elitetq/JAARK/PCB/JAARK_PCB_MOTOR/JAARK_PCB_MOTOR_BOM.xlsx

Prj: | JAARK_PCB_MOTOR.csv |  |  |  | Board Qty: | 1
Co.: |  |  |  |  | Unit Cost: | $13.34
Prj date: | 2026-02-08 11:43:04 (file) |  |  |  | Total Cost: | $13.34 |  |  |  |  | $13.34 | 19 of 19 parts found
$ date: | 2026-02-08 11:43:17
Global Part Info |  |  |  |  |  |  | Digi-Key
Refs | Value | Footprint | Manf# | Qty | Unit$ | Ext$ | Avail | Purch | Unit$ | MOQ | Ext$ | Cat#
C1,C4,C5 | ??? | ??? | CL21B104KBCNNNC | 3 | $0.080 | $0.24 | 3599108 |  | $0.080 | 1 | $0.24 | 1276-1003-1-ND (https://www.digikey.com/en/products/detail/samsung-electro-mechanics/CL21B104KBCNNNC/3886661)
C2 | ??? | ??? | CL21A106KAYNNNG (https://weblib.samsungsem.com/mlcc/mlcc-ec-data-sheet.do?partNumber=CL05Y105KP6VPN) | 1 | $0.150 | $0.15 | 386143 |  | $0.150 | 1 | $0.15 | 1276-6454-1-ND (https://www.digikey.com/en/products/detail/samsung-electro-mechanics/CL21A106KAYNNNG/3894413)
C3,C13,C15 | ??? | ??? | C0805C104K5RACTU (https://yageogroup.com/content/datasheet/asset/file/KEM_C1002_X7R_SMD) | 3 | $0.080 | $0.24 | 5222574 |  | $0.080 | 1 | $0.24 | 399-C0805C104K5RACTUCT-ND (https://www.digikey.com/en/products/detail/kemet/C0805C104K5RACTU/411169)
C6 | ??? | ??? | CL21C221JBANNNC | 1 | $0.100 | $0.10 | 124315 |  | $0.100 | 1 | $0.10 | 1276-1164-1-ND (https://www.digikey.com/en/products/detail/samsung-electro-mechanics/CL21C221JBANNNC/3886822)
C7 | ??? | ??? | UWT1V101MCL1GS (https://www.nichicon.co.jp/english/series_items/catalog_pdf/e-uwt.pdf) | 1 | $0.410 | $0.41 | 235740 |  | $0.410 | 1 | $0.41 | 493-2203-1-ND (https://www.digikey.com/en/products/detail/nichicon/UWT1V101MCL1GS/589944)
C12,C14 | ??? | ??? | C3216X5R1E336M160AC (https://product.tdk.com/system/files/dam/doc/product/capacitor/ceramic/mlcc/catalog/mlcc_commercial_general_en.pdf) | 2 | $1.130 | $2.26 | 71246 |  | $1.130 | 1 | $2.26 | 445-8046-1-ND (https://www.digikey.com/en/products/detail/tdk-corporation/C3216X5R1E336M160AC/2792259)
D4 | ??? | ??? | SMF12CA (https://www.mccsemi.com/pdf/Products/SMF5.0A_SMF200CA(SOD-123FL).pdf) | 1 |  |  | NonStk |  |  | 2500 |  | 353-SMF12CA-TP-ND (https://www.digikey.com/en/products/detail/mcc-micro-commercial-components/SMF12CA-TP/17949888)
IC1 | ??? | ??? | TPS564242DRLR (https://www.ti.com/lit/ds/symlink/tps564242.pdf) | 1 | $0.560 | $0.56 | 12238 |  | $0.560 | 1 | $0.56 | 296-TPS564242DRLRCT-ND (https://www.digikey.com/en/products/detail/texas-instruments/TPS564242DRLR/16585669)
IC9,IC10 | ??? | ??? | DRV8231DDAR (https://www.ti.com/lit/ds/symlink/drv8231.pdf) | 2 | $1.510 | $3.02 | 3151 |  | $1.510 | 1 | $3.02 | 296-DRV8231DDARCT-ND (https://www.digikey.com/en/products/detail/texas-instruments/DRV8231DDAR/16184249)
J1,J5,J6 | ??? | ??? | 1984617 | 3 | $0.860 | $2.58 | 12408 |  | $0.860 | 1 | $2.58 | 277-1721-ND (https://www.digikey.com/en/products/detail/phoenix-contact/1984617/950849)
L1 | ??? | ??? | 74438356018 (https://www.we-online.com/components/products/datasheet/74438356018.pdf) | 1 | $1.940 | $1.94 | 1841 |  | $1.940 | 1 | $1.94 | 732-8231-1-ND (https://www.digikey.com/en/products/detail/würth-elektronik/74438356018/5725346)
Q1#1 | ??? - p1/2 | ??? | SSM3J334R (https://toshiba.semicon-storage.com/info/docget.jsp?did=5579&prodName=SSM3J334R) | 1 | $0.370 | $0.37 | 47397 |  | $0.370 | 1 | $0.37 | SSM3J334RLFCT-ND (https://www.digikey.com/en/products/detail/toshiba-semiconductor-and-storage/SSM3J334R-LF/3863578)
Q1#2 | ??? - p2/2 | ??? | LF (https://www.te.com/commerce/DocumentDelivery/DDEController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) | 1 |  |  | 12000 |  |  | 6000 |  | A104029TR-ND (https://www.digikey.com/en/products/detail/te-connectivity-amp-connectors/583361-3/294165)
R1 | ??? | ??? | CRG0805F220K (https://www.te.com/commerce/DocumentDelivery/DDEController?Action=srchrtrv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) | 1 | $0.100 | $0.10 | 1227152 |  | $0.100 | 1 | $0.10 | A126350CT-ND (https://www.digikey.com/en/products/detail/te-connectivity-passive-product/CRG0805F220K/2380869)
R2 | ??? | ??? | RC0805FR-0730K1L (https://yageogroup.com/content/datasheet/asset/file/PYU-RC_GROUP_51_ROHS_L) | 1 | $0.100 | $0.10 | 95107 |  | $0.100 | 1 | $0.10 | 311-30.1KCRCT-ND (https://www.digikey.com/en/products/detail/yageo/RC0805FR-0730K1L/727845)
R3,R5 | ??? | ??? | RG2012P-203-B-T5 (https://www.susumu.co.jp/dl/?filename=n_catalog_partition01_en.pdf&type=application/pdf) | 2 | $0.100 | $0.20 | 130853 |  | $0.100 | 1 | $0.20 | RG20P20.0KBCT-ND (https://www.digikey.com/en/products/detail/susumu/RG2012P-203-B-T5/1240704)
R4 | ??? | ??? | RC0805FR-0740K2L (https://yageogroup.com/content/datasheet/asset/file/PYU-RC_GROUP_51_ROHS_L) | 1 | $0.100 | $0.10 | 201092 |  | $0.100 | 1 | $0.10 | 311-40.2KCRCT-ND (https://www.digikey.com/en/products/detail/yageo/RC0805FR-0740K2L/727941)
R10,R11 | ??? | ??? | RL1220S-R20-F (https://www.susumu.co.jp/common/pdf/n_catalog_partition08_en.pdf) | 2 | $0.170 | $0.34 | 243936 |  | $0.170 | 1 | $0.34 | RL12S.20FCT-ND (https://www.digikey.com/en/products/detail/susumu/RL1220S-R20-F/432484)
U1 | ??? | ??? | 3586TR (https://www.keyelco.com/product-pdf.cfm?p=1380) | 1 | $0.630 | $0.63 | 54578 |  | $0.630 | 1 | $0.63 | 36-3586TRCT-ND (https://www.digikey.com/en/products/detail/keystone-electronics/3586TR/2746528)
 |  |  |  |  | Total Purchase: | $0.00 | Buy here (https://www.digikey.com/ordering/shoppingcart) |  |  |  | $0.00
KiCost® v1.1.20 |  |  |  |  | Purchase description:
