elitetq/JAARK/PCB/JAARK_PCB_MOTOR/JAARK_PCB_MOTOR.xlsx

Prj: | JAARK_PCB_MOTOR.csv |  |  |  | Board Qty: | 1
Co.: |  |  |  |  | Unit Cost: | $19.26
Prj date: | 2026-02-15 16:47:53 (file) |  |  |  | Total Cost: | $19.26 |  |  |  |  | $19.26 | 21 of 21 parts found
$ date: | 2026-02-15 16:48:51
Global Part Info |  |  |  |  |  |  | Digi-Key
Refs | Value | Footprint | Manf# | Qty | Unit$ | Ext$ | Avail | Purch | Unit$ | MOQ | Ext$ | Cat#
C1,C4,C5 | ??? | ??? | CL21B104KBCNNNC | 3 | $0.080 | $0.24 | 3599108 |  | $0.080 | 1 | $0.24 | 1276-1003-1-ND (https://www.digikey.com/en/products/detail/samsung-electro-mechanics/CL21B104KBCNNNC/3886661)
C2 | ??? | ??? | CL21A106KAYNNNG (https://weblib.samsungsem.com/mlcc/mlcc-ec-data-sheet.do?partNumber=CL05Y105KP6VPN) | 1 | $0.150 | $0.15 | 386143 |  | $0.150 | 1 | $0.15 | 1276-6454-1-ND (https://www.digikey.com/en/products/detail/samsung-electro-mechanics/CL21A106KAYNNNG/3894413)
C3,C8,C9,C13,C15 | ??? | ??? | C0805C104K5RACTU (https://yageogroup.com/content/datasheet/asset/file/KEM_C1002_X7R_SMD) | 5 | $0.080 | $0.40 | 5222574 |  | $0.080 | 1 | $0.40 | 399-C0805C104K5RACTUCT-ND (https://www.digikey.com/en/products/detail/kemet/C0805C104K5RACTU/411169)
C6 | ??? | ??? | CL21C221JBANNNC | 1 | $0.100 | $0.10 | 124315 |  | $0.100 | 1 | $0.10 | 1276-1164-1-ND (https://www.digikey.com/en/products/detail/samsung-electro-mechanics/CL21C221JBANNNC/3886822)
C7 | ??? | ??? | UWT1V101MCL1GS (https://www.nichicon.co.jp/english/series_items/catalog_pdf/e-uwt.pdf) | 1 | $0.410 | $0.41 | 235740 |  | $0.410 | 1 | $0.41 | 493-2203-1-ND (https://www.digikey.com/en/products/detail/nichicon/UWT1V101MCL1GS/589944)
C12,C14 | ??? | ??? | C3216X5R1E336M160AC (https://product.tdk.com/system/files/dam/doc/product/capacitor/ceramic/mlcc/catalog/mlcc_commercial_general_en.pdf) | 2 | $1.130 | $2.26 | 71246 |  | $1.130 | 1 | $2.26 | 445-8046-1-ND (https://www.digikey.com/en/products/detail/tdk-corporation/C3216X5R1E336M160AC/2792259)
D4 | ??? | ??? | SMF12CA (https://www.mccsemi.com/pdf/Products/SMF5.0A_SMF200CA(SOD-123FL).pdf) | 1 |  |  | NonStk |  | MOQ=2500 | 2500 |  | 353-SMF12CA-TP-ND (https://www.digikey.com/en/products/detail/mcc-micro-commercial-components/SMF12CA-TP/17949888)
IC1 | ??? | ??? | TPS564242DRLR (https://www.ti.com/lit/ds/symlink/tps564242.pdf) | 1 | $0.560 | $0.56 | 12238 |  | $0.560 | 1 | $0.56 | 296-TPS564242DRLRCT-ND (https://www.digikey.com/en/products/detail/texas-instruments/TPS564242DRLR/16585669)
IC9,IC10 | ??? | ??? | DRV8231DDAR (https://www.ti.com/lit/ds/symlink/drv8231.pdf) | 2 | $1.510 | $3.02 | 3151 |  | $1.510 | 1 | $3.02 | 296-DRV8231DDARCT-ND (https://www.digikey.com/en/products/detail/texas-instruments/DRV8231DDAR/16184249)
J1,J4-J7 | ??? | ??? | 1984617 | 5 | $0.860 | $4.30 | 12408 |  | $0.860 | 1 | $4.30 | 277-1721-ND (https://www.digikey.com/en/products/detail/phoenix-contact/1984617/950849)
J2 | ??? | ??? | SSW-119-01-T-D | 1 | $3.570 | $3.57 | NonStk |  | $3.570 | 1 | $3.57 | SAM1212-19-ND (https://www.digikey.com/en/products/detail/samtec-inc/SSW-119-01-T-D/1112237)
J3 | ??? | ??? | PPPC061LGBN-RC | 1 | $0.570 | $0.57 | 11923 |  | $0.570 | 1 | $0.57 | S5481-ND (https://www.digikey.com/en/products/detail/sullins-connector-solutions/PPPC061LGBN-RC/775939)
L1 | ??? | ??? | 74438356018 (https://www.we-online.com/components/products/datasheet/74438356018.pdf) | 1 | $1.940 | $1.94 | 1841 |  | $1.940 | 1 | $1.94 | 732-8231-1-ND (https://www.digikey.com/en/products/detail/würth-elektronik/74438356018/5725346)
Q1 | ??? | ??? | SSM3J334R (https://toshiba.semicon-storage.com/info/docget.jsp?did=5579&prodName=SSM3J334R) | 1 | $0.370 | $0.37 | 47397 |  | $0.370 | 1 | $0.37 | SSM3J334RLFCT-ND (https://www.digikey.com/en/products/detail/toshiba-semiconductor-and-storage/SSM3J334R-LF/3863578)
Q2 | ??? | ??? | 2N4403TFR (https://www.onsemi.com/pub/Collateral/2N4403T.PDF) | 1 | $0.190 | $0.19 | 18574 |  | $0.190 | 1 | $0.19 | 2N4403D26ZCT-ND (https://www.digikey.com/en/products/detail/onsemi/2N4403TFR/458822)
R1 | ??? | ??? | CRG0805F220K (https://www.te.com/commerce/DocumentDelivery/DDEController?Action=srchrtrv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) | 1 | $0.100 | $0.10 | 1227152 |  | $0.100 | 1 | $0.10 | A126350CT-ND (https://www.digikey.com/en/products/detail/te-connectivity-passive-product/CRG0805F220K/2380869)
R2 | ??? | ??? | CRG0805F30K (https://www.te.com/commerce/DocumentDelivery/DDEController?Action=srchrtrv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) | 1 | $0.100 | $0.10 | 58878 |  | $0.100 | 1 | $0.10 | A126360CT-ND (https://www.digikey.com/en/products/detail/te-connectivity-passive-product/CRG0805F30K/2380886)
R3 | ??? | ??? | RG2012P-203-B-T5 (https://www.susumu.co.jp/dl/?filename=n_catalog_partition01_en.pdf&type=application/pdf) | 1 | $0.100 | $0.10 | 130853 |  | $0.100 | 1 | $0.10 | RG20P20.0KBCT-ND (https://www.digikey.com/en/products/detail/susumu/RG2012P-203-B-T5/1240704)
R4 | ??? | ??? | RC0805FR-0740K2L (https://yageogroup.com/content/datasheet/asset/file/PYU-RC_GROUP_51_ROHS_L) | 1 | $0.100 | $0.10 | 201092 |  | $0.100 | 1 | $0.10 | 311-40.2KCRCT-ND (https://www.digikey.com/en/products/detail/yageo/RC0805FR-0740K2L/727941)
R10,R11 | ??? | ??? | RL1220S-R20-F (https://www.susumu.co.jp/common/pdf/n_catalog_partition08_en.pdf) | 2 | $0.170 | $0.34 | 243936 |  | $0.170 | 1 | $0.34 | RL12S.20FCT-ND (https://www.digikey.com/en/products/detail/susumu/RL1220S-R20-F/432484)
U1 | ??? | ??? | 3568 (https://www.te.com/usa-en/product-35684.datasheet.pdf) | 1 | $0.440 | $0.44 | 63044 |  | $0.440 | 1 | $0.44 | 35684-ND (https://www.digikey.com/en/products/detail/te-connectivity-amp-connectors/35684/293074)
 |  |  |  |  | Total Purchase: | $0.00 | Buy here (https://www.digikey.com/ordering/shoppingcart) |  |  |  | $0.00
KiCost® v1.1.20 |  |  |  |  | Purchase description: |  |  | #N/A
