elitetq/JAARK/PCB/JAARK_PCB_MOTOR/JAARK_PCB_MOTOR.kicad_pcb

## KiCad design PCB/JAARK_PCB_MOTOR/JAARK_PCB_MOTOR.kicad_pcb (2026-03-23)

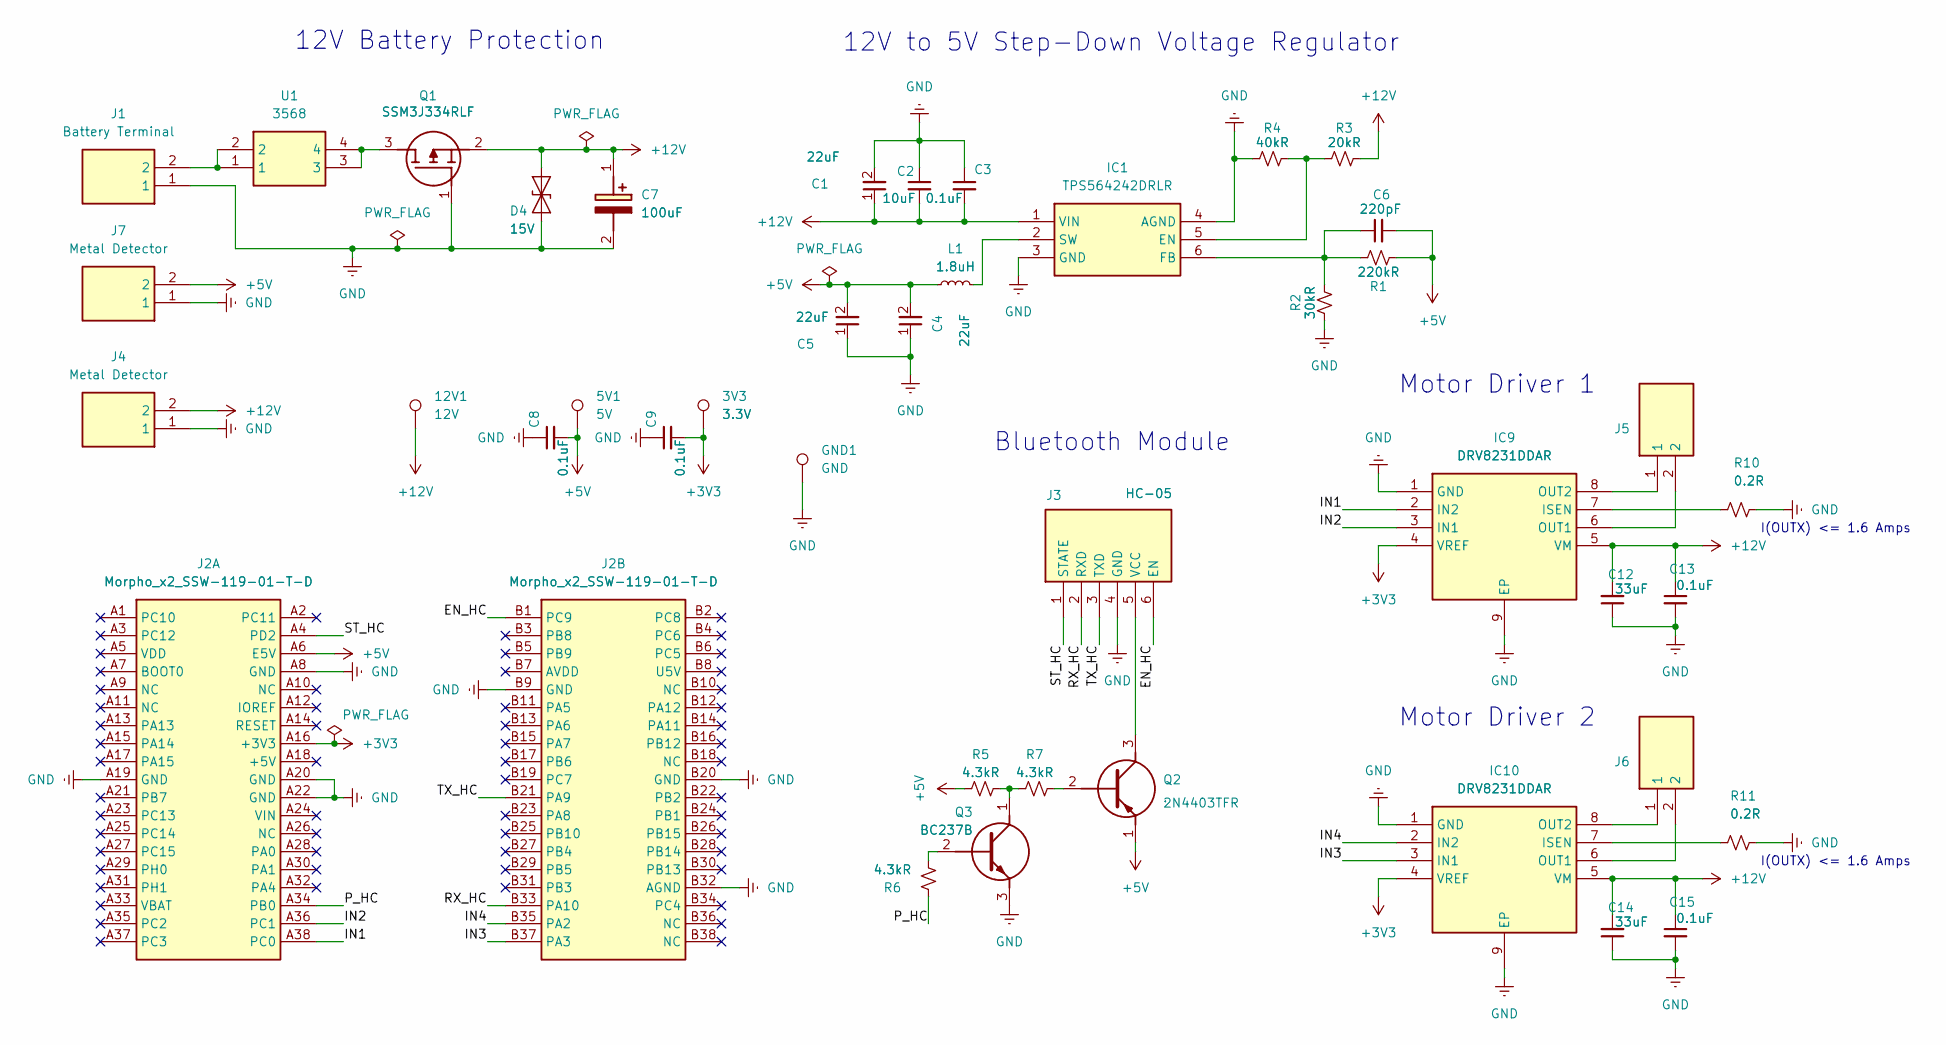
[picture p14: schematic JAARK_PCB_MOTOR.kicad_sch]

Parts:
3V3: 3.3V; TestPoint_Pad_1.5x1.5mm
5V1: 5V; TestPoint_Pad_1.5x1.5mm
12V1: 12V; TestPoint_Pad_1.5x1.5mm
C1: 22uF; CAPC2012X95N; MPN CL21A226MAYNNNE; Mouser Part Number 187-CL21B104KBCNNNC
C2: 10uF; CAPC2012X145N; Manufacturer_Part_Number CL21A106KAYNNNG; Mouser Part Number 187-CL21A106KAYNNNG
C3, C8, C9, C13, C15: 0.1uF; C0805; Manufacturer_Part_Number C0805C104K5RACTU; Mouser Part Number 80-C0805C104K5R
C4, C5: 22uF; CAPC2012X95N; Manufacturer_Part_Number CL21B104KBCNNNC; Mouser Part Number 187-CL21B104KBCNNNC
C6: 220pF; CAPC2012X75N; Manufacturer_Part_Number CL21C221JBANNNC; Mouser Part Number 187-CL21C221JBANNNC
C7: 100uF; CAPAE660X800N; Manufacturer_Part_Number UWT1V101MCL1GS; Mouser Part Number 647-UWT1V101MCL1S
C12, C14: 33uF; CAPC3216X180N; Manufacturer_Part_Number C3216X5R1E336M160AC; Mouser Part Number 810-C3216X5R1E336M
D4: 15V; SODFL3616X135N; Manufacturer_Part_Number SMF12CA
GND1: GND; TestPoint_Pad_1.5x1.5mm
IC1: TPS564242DRLR; SOTFL50P160X60-6N; Manufacturer_Part_Number TPS564242DRLR; Mouser Part Number 595-TPS564242DRLR
IC9, IC10: DRV8231DDAR; SOIC127P600X170-9N; Manufacturer_Part_Number DRV8231DDAR; Mouser Part Number 595-DRV8231DDAR
J1: Battery Terminal; 1984617; Manufacturer_Part_Number 1984617; Mouser Part Number 651-1984617
J2: Morpho_x2_SSW-119-01-T-D; STM_Nucleo_Morpho_x2_Footprint; Manufacturer_Part_Number SSW-119-01-T-D; Mouser Part Number 200-SSW11901TD
J3: HC-05; PPPC061LGBNRC; Manufacturer_Part_Number PPPC061LGBN-RC
J4, J7: Metal Detector; 1984617; Manufacturer_Part_Number 1984617; Mouser Part Number 651-1984617
J5, J6: 1984617; Manufacturer_Part_Number 1984617; Mouser Part Number 651-1984617
L1: 1.8uH; INDPM4141X200N; Manufacturer_Part_Number 74438356018; Mouser Part Number 710-74438356018
Q1: SSM3J334RLF; 2SC2712GRLF; Manufacturer_Part_Number SSM3J334R,LF
Q2: 2N4403TFR; BC33740TA; Manufacturer_Part_Number 2N4403TFR; Mouser Part Number 512-2N4403TFR
Q3: BC237B; TO-92__TO-226_; Manufacturer_Part_Number BC237B; Mouser Part Number 512-BC237B
R1: 220kR; RESC2012X65N; Manufacturer_Part_Number CRG0805F220K; Mouser Part Number 279-CRG0805F220K
R2: 30kR; RESC2012X65N; Manufacturer_Part_Number CRG0805F30K; Mouser Part Number 279-CRG0805F30K
R3: 20kR; RESC2012X50N; Manufacturer_Part_Number RG2012P-203-B-T5; Mouser Part Number 754-RG2012P-203-B-T5
R4: 40kR; RESC2012X60N; Manufacturer_Part_Number RC0805FR-0740K2L; Mouser Part Number 603-RC0805FR-0740K2L
R5, R6, R7: 4.3kR; R_Axial_DIN0207_L6.3mm_D2.5mm_P10.16mm_Horizontal
R10, R11: 0.2R; RESC2013X65N; Manufacturer_Part_Number RL1220S-R20-F; Mouser Part Number 754-RL1220S-R20-F
U1: 3568; Manufacturer_Part_Number 3568; Mouser Part Number 534-3568

Connections:
+3V3: 3V3.1, C9.2, IC9.4 (VREF), IC10.4 (VREF), J2.A16 (+3V3)
+5V: 5V1.1, C4.2, C5.2, C6.2, C8.2, J2.A6 (E5V), J7.2, L1.1, Q2.1 (E), R1.1, R5.1
+12V: 12V1.1, C1.1, C2.2, C3.2, C7.1 (+), C12.2, C13.1, C14.2, C15.1, D4.2 (A2), IC1.1 (VIN), IC9.5 (VM), IC10.5 (VM), J4.2, Q1.2 (S), R3.1
/EN_HC: J2.B1 (PC9), J3.6 (EN)
/IN1: IC9.2 (IN2), J2.A38 (PC0)
/IN2: IC9.3 (IN1), J2.A36 (PC1)
/IN3: IC10.3 (IN1), J2.B37 (PA3)
/IN4: IC10.2 (IN2), J2.B35 (PA2)
/P_HC: J2.A34 (PB0), R6.1
/RX_HC: J2.B33 (PA10), J3.2 (RXD)
/ST_HC: J2.A4 (PD2), J3.1 (STATE)
/TX_HC: J2.B21 (PA9), J3.3 (TXD)
GND: C1.2, C2.1, C3.1, C4.1, C5.1, C7.2 (-), C8.1, C9.1, C12.1, C13.2, C14.1, C15.2, D4.1 (A1), GND1.1, IC1.3 (GND), IC1.4 (AGND), IC9.1 (GND), IC9.9 (EP), IC10.1 (GND), IC10.9 (EP), J1.1, J2.A8 (GND), J2.A19 (GND), J2.A20 (GND), J2.A22 (GND), J2.B9 (GND), J2.B20 (GND), J2.B32 (AGND), J3.4 (GND), J4.1, J7.1, Q1.1 (G), Q3.3 (E), R2.1, R4.2, R10.2, R11.2
unnamed: IC1.5 (EN), R3.2, R4.1
unnamed: C6.1, IC1.6 (FB), R1.2, R2.2
unnamed: IC1.2 (SW), L1.2
unnamed: IC9.7 (ISEN), R10.1
unnamed: IC9.6 (OUT1), J5.2
unnamed: IC9.8 (OUT2), J5.1
unnamed: IC10.7 (ISEN), R11.1
unnamed: IC10.6 (OUT1), J6.2
unnamed: IC10.8 (OUT2), J6.1
unnamed: J1.2, U1.1, U1.2
unnamed: J3.5 (VCC), Q2.3 (C)
unnamed: Q1.3 (D), U1.3, U1.4
unnamed: Q2.2 (B), R7.2
unnamed: Q3.2 (B), R6.2
unnamed: Q3.1 (C), R5.2, R7.1

Notes on the sheet:
I(OUTX) <= 1.6 Amps
Bluetooth Module
Motor Driver 2
12V to 5V Step-Down Voltage Regulator
Motor Driver 1
12V Battery Protection

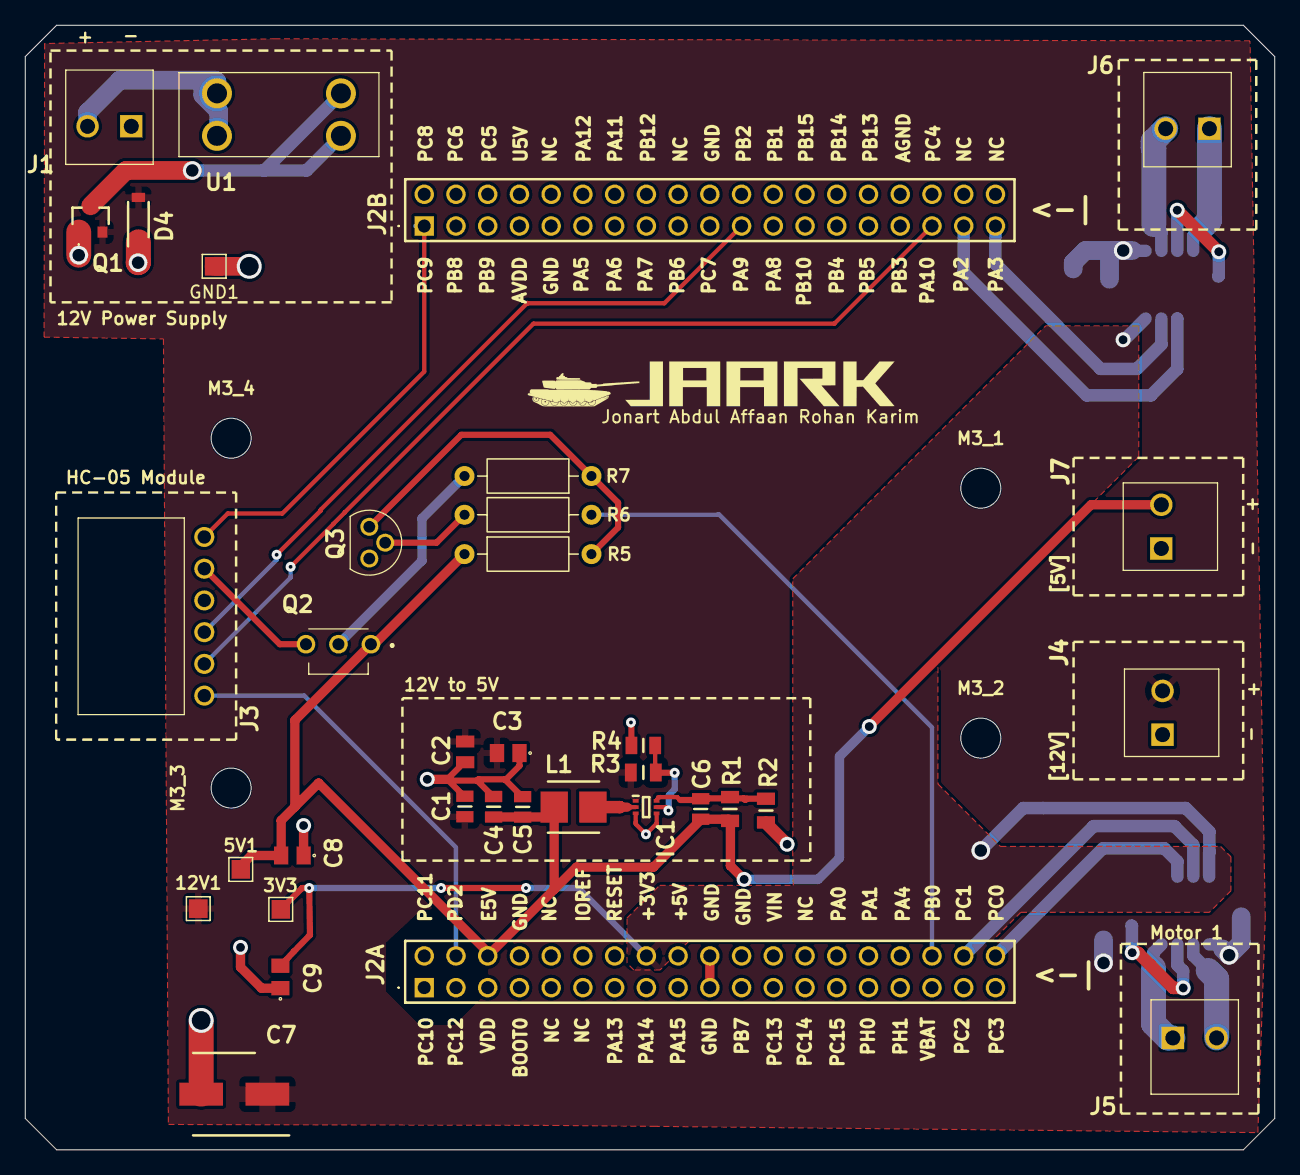
[picture p15: board JAARK_PCB_MOTOR.kicad_pcb from above]

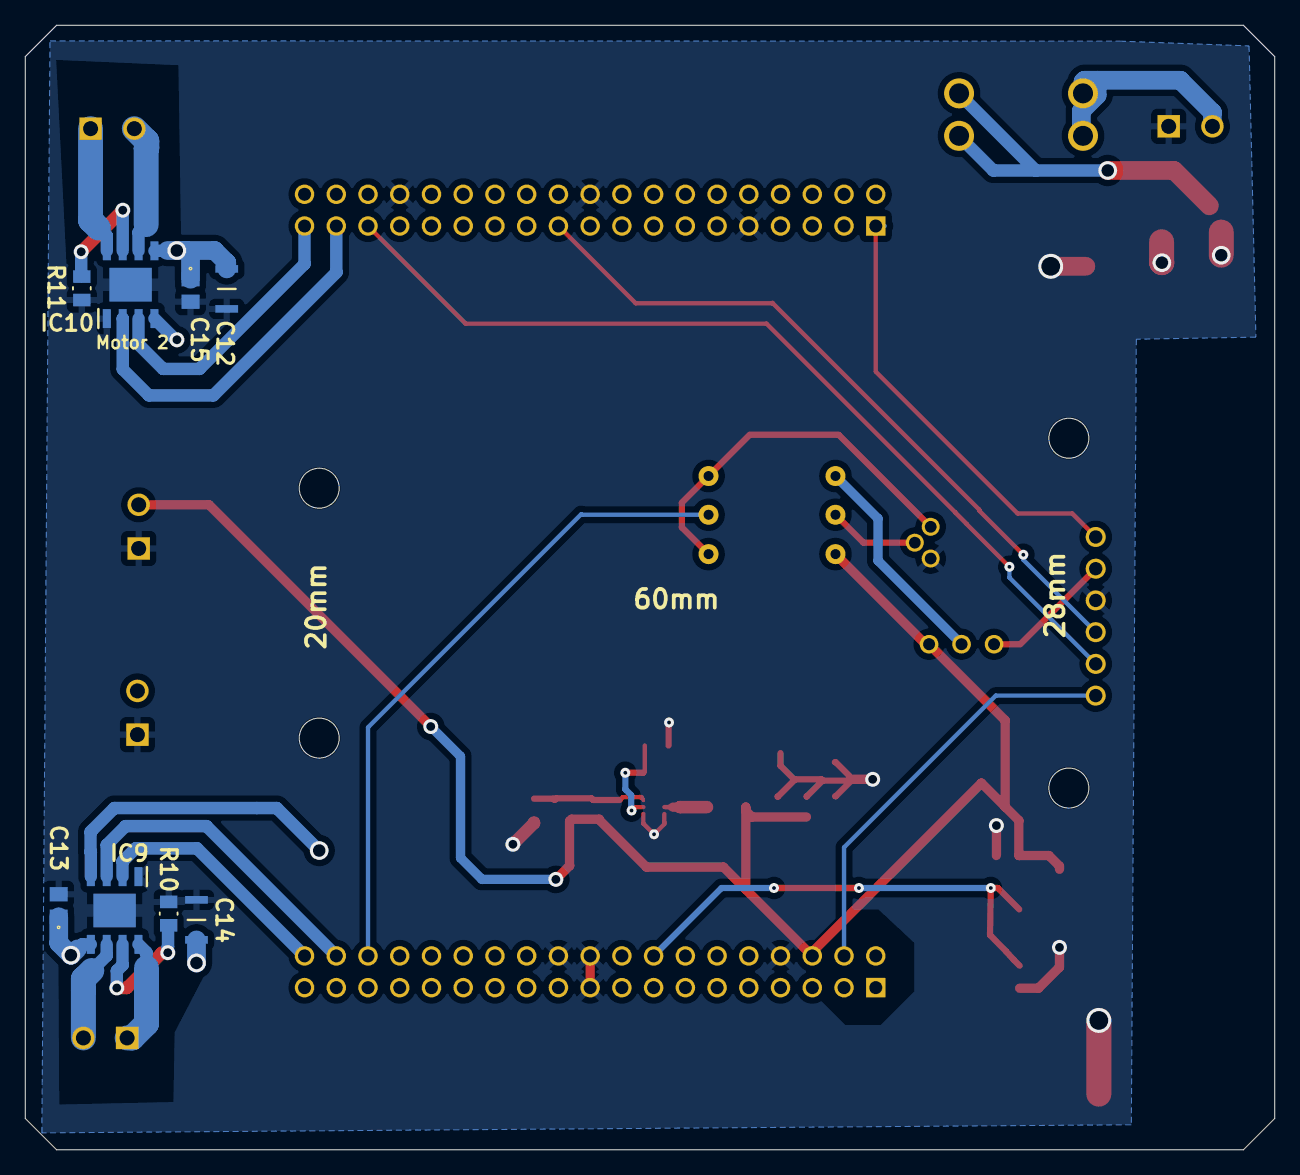
[picture p16: board JAARK_PCB_MOTOR.kicad_pcb from below]

Board: 2 copper layers, 100.0 x 90.0 mm, 46 parts (8 on the bottom side), 28 nets.

Other parts of the board:
M3_1: M3_1; MountingHole_3.2mm_M3
M3_2: M3_2; MountingHole_3.2mm_M3
M3_3: M3_3; MountingHole_3.2mm_M3
M3_4: M3_4; MountingHole_3.2mm_M3
