elitetq/JAARK/STM32/PCB_MOTOR_STM/PCB_MOTOR_STM.ioc

Mcu.UserName=STM32F446RETx
PA0-WKUP.Signal=S_TIM5_CH1
PA1.Signal=GPIO_Output
PA10.Signal=USART1_RX
PA13.GPIO_Label=TMS
PA13.Signal=SYS_JTMS-SWDIO
PA14.GPIO_Label=TCK
PA14.Signal=SYS_JTCK-SWCLK
PA15.Signal=S_TIM2_CH1_ETR
PA2.Signal=USART2_TX
PA3.Signal=USART2_RX
PA4.Signal=ADCx_IN4
PA5.GPIO_Label=LD2 [Green Led]
PA5.Signal=GPIO_Output
PA9.Signal=USART1_TX
PB0.Signal=GPIO_Output
PB10.Signal=GPXTI10
PB14.Signal=S_TIM12_CH1
PB3.GPIO_Label=SWO
PB3.Signal=SYS_JTDO-SWO
PB4.Signal=GPIO_Output
PB7.Signal=GPIO_Output
PB8.Signal=S_TIM10_CH1
PB9.Signal=S_TIM11_CH1
PC0.Signal=GPIO_Input
PC1.Signal=GPIO_Input
PC10.Signal=SPI3_SCK
PC12.Signal=SPI3_MOSI
PC13.GPIO_Label=B1 [Blue PushButton]
PC13.Signal=GPXTI13
PC14-OSC32_IN.Signal=RCC_OSC32_IN
PC15-OSC32_OUT.Signal=RCC_OSC32_OUT
PC2.Signal=GPIO_Input
PC3.Signal=GPIO_Input
PC4.Signal=GPIO_Output
PC6.Signal=S_TIM8_CH1
PC8.Signal=S_TIM8_CH3
PC9.Signal=S_TIM8_CH4
PH0-OSC_IN.Signal=RCC_OSC_IN
PH1-OSC_OUT.Signal=RCC_OSC_OUT
