elitetq/JAARK/STM32/STM32_CONTROLLER/Core/Src/main.c

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
/* Includes ------------------------------------------------------------------*/
#include "main.h"
#include "adc.h"
#include "dma.h"
#include "spi.h"
#include "tim.h"
#include "usart.h"
#include "gpio.h"
#include "string.h"

/* USER CODE BEGIN Includes */
#include "j_st7789.h"

/* USER CODE END Includes */

/* USER CODE BEGIN PM */
// Slave address 2025:08:004B82

/* USER CODE END PM */


/* USER CODE BEGIN PV */
// uint8_t rx_buf[1]; // Data we receive
// uint8_t tx_buf[1]; // Data to transmit
uint8_t pc_rx_buf[1];
uint8_t hc_rx_buf[1];

volatile union { 
  float fnum;
  uint8_t bytes[7];
} FloatPacket; // Float bytes for distance
volatile float fnum_stored = 0;
volatile float sensor_val_stored = 10;
#define SENSOR_DAMP 0.4
#define EXP_SMOOTH(prev_val,new_val,damping_factor) (prev_val * (1-damping_factor) + new_val * (damping_factor));

volatile char metal_detect_flag = 0;
volatile char headlight_flag = 0;

volatile char bt_dat_avail = 0;
volatile char bt_timeout = 0;
volatile uint32_t hal_adc_val = 0; // X
volatile uint32_t hal_adc_val2 = 0; // Y

volatile uint32_t hal1_write_up_prev = 0;
volatile uint32_t hal2_write_up_prev = 0;
volatile uint32_t hal1_write_down_prev = 0;
volatile uint32_t hal2_write_down_prev = 0;
volatile uint8_t hal_combined[4] = {0,0,0,0}; // index 1 {Joystick Data} : index 2 {Headlight Data}
const uint8_t checksum_index = 2;

volatile char headlight_update_debounce = 0;

#define BT_BUF_SIZE 30
#define BG_COL J_BLACK
#define WATCHDOG_BG_COL J_RED

/* USER CODE END PV */

void SystemClock_Config(void);
/* USER CODE BEGIN PFP */

void Reset_DMA_Channel(UART_HandleTypeDef *huart, uint8_t *pData, uint8_t size) {
}


/**
 * @brief generate a checksum for the array given at the checksum index
 * 
 * @param arr Array to be sifted through
 * @param chksum_ind index of checksum (must allow for 2 bytes of storage on an array), if less than 0, will not store any value on the array
 * 
 */
uint16_t Checksum_Generate(uint8_t* arr, int chksum_ind) {
  // Using fletcher 16 algorithm
  uint8_t s1 = 0;
  uint8_t s2 = 0;
  char do_arr_replacement = 1;
  if(chksum_ind < 0) {
    chksum_ind = chksum_ind * -1;
    do_arr_replacement = 0;
  }
  for(int i = 0; i < chksum_ind; i++) {
    s1 += arr[i];
    s2 += s1;
  }
  if(do_arr_replacement) {
    arr[chksum_ind] = s2;
    arr[chksum_ind+1] = s1;
  }
  return ((uint16_t)s2 << 8) + (uint16_t)s1;
}

void Setup_Main_Screen() {
  set_bounds(0,239,0,239);
  set_bg_col(BG_COL);
  fill_area(get_bg_col());

  fill_text(120,90,"Distance (cm)",13,J_11X18_FONT,J_WHITE,J_CENTER);
}

void BT_Watchdog() {
  if(bt_timeout) {
    bt_dat_avail = 0;
    set_bounds(0,239,0,239);
    set_bg_col(WATCHDOG_BG_COL);
    fill_area(get_bg_col());

    fill_text(120,75,"WATCHDOG",-1,J_16X26_FONT,J_WHITE,J_CENTER);
    fill_text(120,102,"No Bluetooth Signal",-1,J_11X18_FONT,J_WHITE,J_CENTER);
    fill_text(120,125,"Attempting Reconnect...",-1,J_7X10_FONT,J_WHITE,J_CENTER);

    HAL_Delay(15);

    uint8_t rec_index1, rec_index2, rec_flag1, rec_flag2, x_pos, y_pos, width;
    rec_index2 = 0;
    rec_index1 = 1;
    rec_flag1 = 0;
    rec_flag2 = 0;
    x_pos = 100;
    y_pos = 165;
    width = 20;

    // 1. Completely abort the UART reception and reset its state machine to READY
    HAL_UART_AbortReceive(&huart1);

    // 2. Clear any lingering hardware errors caused by the disconnect/static
    __HAL_UART_CLEAR_OREFLAG(&huart1);
    __HAL_UART_CLEAR_FEFLAG(&huart1);
    __HAL_UART_CLEAR_NEFLAG(&huart1);

    HAL_UARTEx_ReceiveToIdle_DMA(&huart1, FloatPacket.bytes, sizeof(FloatPacket.bytes));
    __HAL_DMA_DISABLE_IT(huart1.hdmarx, DMA_IT_HT);


    while(!bt_dat_avail) {
      printf("WATCHDOG | Attempting reconnect...");
      // Wait until bluetooth data is received
      set_bounds(x_pos+rec_flag1*width,x_pos+width*(1+rec_flag1),y_pos+rec_flag2*width,y_pos+width*(1+rec_flag2)); // Loading bar
      fill_area(J_WHITE);
      // HAL_UART_Receive_DMA(&huart1,FloatPacket.bytes,4); // Receive ultrasonic data
      // HAL_UART_DMAStop(&huart1); 
      // HAL_UART_Receive_DMA(&huart1,FloatPacket.bytes,sizeof(FloatPacket));
      HAL_UART_Transmit(&huart1,hal_combined,sizeof(hal_combined),100);

      HAL_Delay(50);

      fill_area(get_bg_col());
      rec_index1++;
      rec_index2++;
      if(rec_index1 >= 2) {
        rec_flag1 = !rec_flag1;
        rec_index1 %= 2;
      }
      if(rec_index2 >= 2) {
        rec_flag2 = !rec_flag2;
        rec_index2 %= 2;
      }
      if(huart1.RxState != HAL_UART_STATE_BUSY_RX) {
        HAL_UART_AbortReceive(&huart1);

        __HAL_UART_CLEAR_OREFLAG(&huart1);
        __HAL_UART_CLEAR_FEFLAG(&huart1);
        __HAL_UART_CLEAR_NEFLAG(&huart1);

        HAL_UARTEx_ReceiveToIdle_DMA(&huart1, FloatPacket.bytes, sizeof(FloatPacket.bytes));
        __HAL_DMA_DISABLE_IT(huart1.hdmarx, DMA_IT_HT);
      }
    }
    Setup_Main_Screen();
    if(hal_combined[1]) {
      fill_text(120,40,"Headlight:  ON",14,J_11X18_FONT,J_WHITE,J_CENTER);
    } else {
      fill_text(120,40,"Headlight: OFF",14,J_11X18_FONT,J_WHITE,J_CENTER);
    }

    // Make sure we are back in sync with data
    // HAL_UART_DMAStop(&huart1); // A timeout means unexpected drop in bt connection, we need to disable dma in case of data corruption
    // HAL_Delay(100);
    // memset(FloatPacket.bytes,0,6);
    // HAL_UART_Receive_DMA(&huart1,FloatPacket.bytes,sizeof(FloatPacket));

    __HAL_TIM_SET_COUNTER(&htim3,0); // Reset watchdog timer
    bt_timeout = 0;
  }
}

void HAL_TIM_PeriodElapsedCallback(TIM_HandleTypeDef *htim) {
  if(htim->Instance == TIM3) {
    bt_timeout = 1;
  } else if (htim->Instance == TIM1) {
    headlight_update_debounce = 0;
  }
}

int _write(int file, char *ptr, int len) {
  for(int i = 0; i < len; i++) {
    ITM_SendChar(*ptr++);
  }
  return len;
}
/* USER CODE END PFP */

/**
  * @brief  The application entry point.
  * @retval int
  */
int main(void)
{

  /* MCU Configuration--------------------------------------------------------*/

  /* Reset of all peripherals, Initializes the Flash interface and the Systick. */
  HAL_Init();

  /* Configure the system clock */
  SystemClock_Config();

  /* Initialize all configured peripherals */
  MX_GPIO_Init();
  MX_DMA_Init();
  MX_ADC2_Init();
  MX_USART1_UART_Init();
  MX_USART2_UART_Init();
  MX_ADC1_Init();
  MX_TIM3_Init();
  MX_SPI2_Init();
  MX_TIM1_Init();
  /* USER CODE BEGIN 2 */
  GPIO_InitTypeDef GPIO_InitStruct = {0};
  GPIO_InitStruct.Pin = GPIO_PIN_10;
  GPIO_InitStruct.Mode = GPIO_MODE_AF_PP;   // Alternate Function Push-Pull
  GPIO_InitStruct.Pull = GPIO_PULLUP;      // This prevents the "float"
  GPIO_InitStruct.Speed = GPIO_SPEED_FREQ_HIGH;
  GPIO_InitStruct.Alternate = GPIO_AF7_USART1; // AF7 is standard for UART on PA10
  HAL_GPIO_Init(GPIOA, &GPIO_InitStruct);
  // HAL_UART_Receive_IT(&huart2, pc_rx_buf, 1);
  // HAL_UART_Receive_IT(&huart1, hc_rx_buf, 1);

  // HAL_UART_Receive_DMA(&huart1,FloatPacket.bytes,sizeof(FloatPacket)); // Receive ultrasonic data

  HAL_UARTEx_ReceiveToIdle_DMA(&huart1,FloatPacket.bytes,sizeof(FloatPacket.bytes));
  __HAL_DMA_DISABLE_IT(huart1.hdmarx,DMA_IT_HT);

  uint8_t cmd_at[] = "AT\r\n";
  uint8_t cmd_role[] = "AT+ADDR?\r\n";  // Setting to Slave
  uint8_t rx_buffer[BT_BUF_SIZE] = {0};

  HAL_TIM_Base_Start_IT(&htim3); // 16-bit bluetooth watchdog timer (currently configured for 1s timeout)
  HAL_TIM_Base_Start_IT(&htim1); // Debounce for headlights



  /* USER CODE END 2 */

  /* Infinite loop */
  /* USER CODE BEGIN WHILE */
  init_lcd(J_270_DEG);
  Setup_Main_Screen();
  fill_text(120,40,"Headlight: OFF",14,J_11X18_FONT,J_WHITE,J_CENTER);

  j_counter my_counter = J_CREATE_COUNTER;



  HAL_GPIO_WritePin(GPIOB,GPIO_PIN_12,GPIO_PIN_SET);
  while (1)
  {
    // printf("Data received: [ ");
    // for(int i = 0; i < sizeof(FloatPacket.bytes); i++) {
    //   printf("%d ", FloatPacket.bytes[i]);
    // }
    // printf("]\n");
    /* USER CODE END WHILE */

    /* USER CODE BEGIN 3 */
    HAL_ADC_Start(&hadc1);
    HAL_ADC_PollForConversion(&hadc1,1000);
    hal_adc_val = HAL_ADC_GetValue(&hadc1);

    HAL_ADC_Start(&hadc2);
    HAL_ADC_PollForConversion(&hadc2,1000);
    hal_adc_val2 = HAL_ADC_GetValue(&hadc2);

    hal_adc_val = (hal_adc_val << 4) >> 12; // cnv from 12-bit to 4-bit
    hal_adc_val2 = (hal_adc_val2 << 4) >> 12;

    hal_combined[0] = ((hal_adc_val << 4) | (hal_adc_val2));

    //hal_combined[0] = 0xF0;

    if(!headlight_update_debounce) {
      if(!(HAL_GPIO_ReadPin(GPIOC,GPIO_PIN_3) && HAL_GPIO_ReadPin(GPIOB,GPIO_PIN_4))) {
        hal_combined[1] = !hal_combined[1]; // Toggle headlight
        headlight_update_debounce = 1;
      }
      __HAL_TIM_SET_COUNTER(&htim1,0);
      printf("HEADLIGHT VAL: %d\n\n", hal_combined[1]);
    }
    Checksum_Generate(hal_combined,sizeof(hal_combined)-2);

    if(headlight_flag) {
      if(!hal_combined[1]) {
        fill_text(120,40,"Headlight: OFF",14,J_11X18_FONT,J_WHITE,J_CENTER);
        headlight_flag = 0;
      }
    } else {
      if(hal_combined[1]) {
        fill_text(120,40,"Headlight:  ON",14,J_11X18_FONT,J_WHITE,J_CENTER);
        headlight_flag = 1;
      }
    }



    HAL_UART_Transmit(&huart1,hal_combined,sizeof(hal_combined),100);
    HAL_Delay(5); // important for IDLE line

    if(bt_dat_avail) {
      bt_dat_avail = 0;
      __HAL_TIM_SET_COUNTER(&htim3,0); // Reset watchdog timer
      // printf("Distance received: [%d %d %d %d] %lf\n",FloatPacket.bytes[0],
      // FloatPacket.bytes[1],
      // FloatPacket.bytes[2],
      // FloatPacket.bytes[3], FloatPacket.fnum);
      // printf("Data received: %lf", fnum_stored);
      // Writing to LCD
      // add_value_sensor(fnum_stored);
      sensor_val_stored = EXP_SMOOTH(sensor_val_stored,fnum_stored,SENSOR_DAMP);
      fill_counter(&my_counter,120,120,sensor_val_stored,J_16X26_FONT,J_WHITE,J_CENTER);

      // Check metal detector
      if(metal_detect_flag) {
        if(FloatPacket.bytes[4] == 0) {
          metal_detect_flag = 0;
          set_bounds(25,214,190,239);
          fill_area(get_bg_col());
        }
      } else {
        if(FloatPacket.bytes[4] == 1) {
          metal_detect_flag = 1;
          fill_text(120,200,"Metal Detected",14,J_11X18_FONT,J_WHITE,J_CENTER);
        }
      }

      int hal_adc_val1_write = (hal_adc_val*8)/7;
      fill_lbar_vert(5,234,hal_adc_val2,hal2_write_up_prev,15,10,230,J_WHITE);
      fill_lbar_vert(224,234,hal_adc_val1_write,hal1_write_up_prev,15,10,230,J_WHITE);
      hal1_write_up_prev = hal_adc_val1_write;
      hal2_write_up_prev = hal_adc_val2;

    }

    // printf("Joystick Vals: %d %d\nHeadlight Val: %d\n\n",hal_adc_val,hal_adc_val2,hal_combined[1]);
  

    HAL_Delay(10);

    BT_Watchdog();
  }
  /* USER CODE END 3 */
}

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
/* USER CODE BEGIN 4 */

void Send_HC_AT_Command(char *str, uint8_t *rx_buf) {
  int i = 0;
  while(str[i]) { // Get length
    i++;
  }
  char local_str[64];
  memset(local_str,0,sizeof(local_str));
  
  strcpy(local_str,"-- Sending -> ");
  if(i <= 40)
    strcat(local_str,str);

  HAL_UART_Transmit(&huart2, (uint8_t*)local_str, strlen(local_str), 100);
  HAL_UART_Transmit(&huart1, (uint8_t*)str, i, 100);

  memset(rx_buf, 0, BT_BUF_SIZE);
  
  HAL_UART_Receive(&huart1, rx_buf, BT_BUF_SIZE, 500);
  HAL_UART_Transmit(&huart2, rx_buf, BT_BUF_SIZE, 100);
}

// void HAL_UART_RxCpltCallback(UART_HandleTypeDef *huart)
// {
//   if (huart->Instance == USART1) 
//   {
//     bt_dat_avail = 1; // Let main know we have new bluetooth data
//     fnum_stored = FloatPacket.fnum;
//   }
// }

void HAL_UARTEx_RxEventCallback(UART_HandleTypeDef *huart, uint16_t Size) {
  if(huart->Instance == USART1) {
    int fp_size = sizeof(FloatPacket.bytes);
    uint16_t checksum = Checksum_Generate(FloatPacket.bytes,-1 * (fp_size-2));
    if(checksum == ((FloatPacket.bytes[fp_size-2] << 8) + FloatPacket.bytes[fp_size-1])) {
      // Valid data
      bt_dat_avail = 1;
      fnum_stored = FloatPacket.fnum;
      HAL_UARTEx_ReceiveToIdle_DMA(&huart1,FloatPacket.bytes,fp_size);
    } else { // Hunt mode
      for(int i = 0; i < fp_size-1; i++) {
        FloatPacket.bytes[i] = FloatPacket.bytes[i+1];
      }
      HAL_UARTEx_ReceiveToIdle_DMA(&huart1,&FloatPacket.bytes[fp_size-1],1);
    }
    __HAL_DMA_DISABLE_IT(huart->hdmarx,DMA_IT_HT);
  }

}


void HAL_UART_ErrorCallback(UART_HandleTypeDef *huart)
{
    
    // if(huart->Instance == USART2)
    // {
    //     HAL_UART_Receive_IT(&huart2, pc_rx_buf, 1);
    // }
}
/* USER CODE END 4 */
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
