elitetq/JAARK/STM32/PCB_MOTOR_STM/Core/Inc/main.h

#define B1_Pin GPIO_PIN_13
#define B1_GPIO_Port GPIOC
#define B1_EXTI_IRQn EXTI15_10_IRQn
#define LD2_Pin GPIO_PIN_5
#define LD2_GPIO_Port GPIOA
#define TMS_Pin GPIO_PIN_13
#define TMS_GPIO_Port GPIOA
#define TCK_Pin GPIO_PIN_14
#define TCK_GPIO_Port GPIOA
#define SWO_Pin GPIO_PIN_3
#define SWO_GPIO_Port GPIOB
#define CMD_SLPIN 0x10
#define CMD_SLPOUT 0x11
#define CMD_NORON 0x13
#define CMD_DISPON 0x29
#define CMD_DISPOFF 0x28
#define CMD_SWFRES 0x01
#define CMD_COLMOD 0x3A
#define CMD_MADCTL 0x36
#define CMD_RAMWR 0x2C
#define CMD_INVON 0x21
#define CMD_INVOFF 0x20
#define CMD_CASET 0x2A
#define CMD_RASET 0x2B
#define J_DC GPIO_PIN_0
#define J_DC_PORT GPIOC
#define J_RES GPIO_PIN_4
#define J_RES_PORT GPIOC
