elitetq/JAARK/STM32/STM32_CONTROLLER/Core/Inc/j_fonts.h

#ifndef J_FONTS_H_
#define J_FONTS_H_

#include "inttypes.h"
#include "stdio.h"
#include "j_st7789.h"
// FONT CFG (comment out any font sizes you dont want to load)
#define J_LOAD_7X10
#define J_LOAD_11X18
#define J_LOAD_16X26

#define J_MAX_PRINT_SIZE 20

#define J_KERNING 0// Spacing between letters
// -----------------------------------------------------------


// Font sizes
#define J_7X10_FONT 0x00
#define J_11X18_FONT 0x01
#define J_16X26_FONT 0x02

#define J_FONT_BUFFER_SIZE (J_CFG_SCREEN_LENGTH*2)

static const int j_fonts_height[4] = {10,18,26,0};
static const int j_fonts_length[4] = {7,11,16,0};
static uint8_t j_fonts_buffer[J_FONT_BUFFER_SIZE];


// Function prototypes
const uint16_t* char_ptr_ret(char item, uint8_t font_size);


// Font bits
#ifdef J_LOAD_7X10
static const uint16_t Font7x10 [] = {
0x0000, 0x0000, 0x0000, 0x0000, 0x0000, 0x0000, 0x0000, 0x0000, 0x0000, 0x0000,  // sp
0x1000, 0x1000, 0x1000, 0x1000, 0x1000, 0x1000, 0x0000, 0x1000, 0x0000, 0x0000,  // !
0x2800, 0x2800, 0x2800, 0x0000, 0x0000, 0x0000, 0x0000, 0x0000, 0x0000, 0x0000,  // "
0x2400, 0x2400, 0x7C00, 0x2400, 0x4800, 0x7C00, 0x4800, 0x4800, 0x0000, 0x0000,  // #
0x3800, 0x5400, 0x5000, 0x3800, 0x1400, 0x5400, 0x5400, 0x3800, 0x1000, 0x0000,  // $
0x2000, 0x5400, 0x5800, 0x3000, 0x2800, 0x5400, 0x1400, 0x0800, 0x0000, 0x0000,  // %
0x1000, 0x2800, 0x2800, 0x1000, 0x3400, 0x4800, 0x4800, 0x3400, 0x0000, 0x0000,  // &
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
};

#endif

// Font array
static const uint16_t* j_fonts[4] = {
#ifdef J_LOAD_7X10
		Font7x10,
#else
		NULL,
#endif
#ifdef J_LOAD_11X18
		Font11x18,
#else
		NULL,
#endif
#ifdef J_LOAD_16X26
		Font16x26,
#else
        NULL,
#endif
NULL
};

#endif // J_FONTS_H_=
