elitetq/JAARK/STM32/STM32_CONTROLLER/Core/Inc/j_st7789.h

/*
 * j_st7789.h
 *  
 * This library is aimed at making controlling your ST7789 hardware easier.
 * Please take the time to edit the configuration variables below to your LCD
 * display.
 *
 *  Created on: Feb 4, 2026
 *      Author: jonar
 */

#ifndef J_ST7789_H_
#define J_ST7789_H_
#include "main.h"
#include "spi.h"
#include "usart.h"
#include "gpio.h"
#include "math.h"
#include <stdlib.h>
#include <stdio.h>
#include <stdbool.h>

// J_ST CFG ------------------------------
#define J_CFG_DC_PIN GPIO_PIN_6
#define J_CFG_DC_PORT GPIOA

#define J_CFG_RES_PIN GPIO_PIN_6
#define J_CFG_RES_PORT GPIOB

// Warning, these must be smaller than or equal to 320
#define J_CFG_SCREEN_LENGTH 240 
#define J_CFG_SCREEN_HEIGHT 240

#define J_CFG_BYTES_PER_PIXEL 2

#define J_CFG_SPI_OBJ hspi2
// ----------------------------------------


#include "j_fonts.h"

// PRIVATE DEFINES (do not change) --------
#define CMD_SLPIN   0x10
#define CMD_SLPOUT  0x11
#define CMD_NORON   0x13
#define CMD_DISPON  0x29
#define CMD_DISPOFF 0x28
#define CMD_SWFRES  0x01
#define CMD_COLMOD  0x3A


#define CMD_MADCTL 0x36

#define J_0_DEG   0b00000000
#define J_180_DEG 0b11000000
#define J_90_DEG  0b01100000
#define J_270_DEG 0b10100000


#define CMD_RAMWR  0x2C
#define CMD_INVON  0x21
#define CMD_INVOFF 0x20
#define CMD_CASET  0x2A
#define CMD_RASET  0x2B

#define J_BIT_DEPTH J_CFG_BYTES_PER_PIXEL
#define J_HEIGHT J_CFG_SCREEN_HEIGHT
#define J_LENGTH J_CFG_SCREEN_LENGTH
#define J_DIV 3
#define J_BUF_SIZE (J_HEIGHT * (J_LENGTH/J_DIV) * 2)

#define J_CREATE_COUNTER ((j_counter){.start_x = -1, .end_x = -1, .prev_val = 0})
#define J_CLAMP_VALUE(value, max_val, min_val) ((value > max_val) ? (max_val) : ((value < min_val) ? min_val : value))

#define MAX_TEXT_TO_STRING_SIZE 10
#define MAX_DECIMAL_SIZE 2
// ----------------------------------------

typedef enum {
    J_WHITE = 0xFFFF,
    J_BLACK = 0x0000,
    J_BLUE = 0x001F,
    J_CYAN = 0x00EF,
    J_RED = 0xF800,
    J_PINK = 0xF00F,
    J_GREEN = 0x07E0,
    J_YELLOW = 0xFFE0
} j_color;

typedef enum {
    J_TEXT = 0,
    J_SHAPE
} j_entity_type;

typedef struct {
    j_entity_type type;
    uint8_t x, y;
    
} j_entity;

typedef enum {
    J_LEFT = 0,
    J_CENTER,
    J_RIGHT
} j_centering;

typedef struct {
    j_color bgcol;
    uint8_t num_entities;
    
} j_struct;

typedef struct {
    float prev_val;
    int16_t start_x, end_x; // Previous values
} j_counter;


static uint16_t j_bounds[] = {0,J_CFG_SCREEN_LENGTH,0,J_CFG_SCREEN_HEIGHT};
static char j_flag_set_bounds = 1;

static j_struct j_master_control = { // We should change this to be more user-friendly
    J_BLUE,
    0
};



/**
 * @brief Write comand via SPI
 * 
 * @param CMD 8-bit command
 */
void write_cmd(uint8_t CMD);
/**
 * @brief write multiple 8-bit integers via SPI
 * 
 * @param dat Data pointer to uint8_t array
 * @param len Length of array
 */
void write_u8(uint8_t* dat, size_t len);
/**
 * @brief Write single line of 8-bit data via SPI
 * 
 * @param dat 8-bit data
 */
void write_s8(uint8_t dat);
/**
 * @brief Initialize the LCD by sending the basic commands
 * 
 * @param rot_value Rotation uint8_t command for MAD_CTL, see the J_XXX_DEG defines
 */
void init_lcd(uint8_t rot_value);
/**
 * @brief Set bounds of the screen for drawing
 * 
 * @param xlo Low X coordinate
 * @param xhi High X coordinate
 * @param ylo Low Y coordinate
 * @param yhi High Y coordinate
 */
void set_bounds(uint16_t xlo, uint16_t xhi, uint16_t ylo, uint16_t yhi);
void fill_area(uint16_t color);
void fill_text(uint8_t x, uint8_t y, char* str, int len, uint8_t font_size, j_color color, j_centering CENTERING);
void draw_text(char ch, uint8_t font_size, j_color FILL_COL);
void fill_counter(j_counter* counter, uint16_t x, uint16_t y, float num, uint8_t font_size, j_color FILL_COL, j_centering CENTERING);
int fill_lbar(uint8_t x, uint8_t y, int value, int prev_value, int full_val, int length, int height, j_color col);
int fill_lbar_vert(uint8_t x, uint8_t y, int value, int prev_value, int full_val, int length, int height, j_color col);
int fill_lbar_vert_down(uint8_t x, uint8_t y, int value, int prev_value, int full_val, int length, int height, j_color col);
void set_bg_col(j_color color);
j_color get_bg_col();

#endif /* J_ST7789_H_ */
