elitetq/JAARK/(commit log)

2026-01-28 Started initial progress on 5V step down circuit.
    [JAARK_PCB_MOTOR.kicad_pcb, JAARK_PCB_MOTOR.kicad_sch]
2026-02-01 Work on Motor Driver H-Bridge. May need to consider switching to MOSFET, as BJT's are not suitable for high amp loads. Could fry board or resistors with the current H-Bridge setup.
    [JAARK_PCB_MOTOR.kicad_pcb, JAARK_PCB_MOTOR.kicad_sch]
2026-02-02 Finished H-Bridge
    [JAARK_PCB_MOTOR.kicad_sch]
2026-02-02 Organizing libraries in the local folder.
    [JAARK_PCB_MOTOR.kicad_pcb, JAARK_PCB_MOTOR.kicad_sch]
2026-02-03 Starting zephyr testing
    [JAARK_PCB_MOTOR.kicad_sch]
2026-02-04 Motor driver recreation, appended footprints to lots of R,L,C elements
    [JAARK_PCB_MOTOR.csv, JAARK_PCB_MOTOR.kicad_pcb, JAARK_PCB_MOTOR.kicad_sch, JAARK_PCB_MOTOR.xlsx]
2026-02-04 Fixed footprints for sharing
    [JAARK_PCB_MOTOR.csv, JAARK_PCB_MOTOR.kicad_pcb, JAARK_PCB_MOTOR.kicad_sch, JAARK_PCB_MOTOR.xlsx]
2026-02-05 holy shit its working
    [PCB_MOTOR_STM Debug.cfg]
2026-02-06 Better motor drivers, fixed capacitor in voltage regulation.
    [JAARK_PCB_MOTOR.kicad_pcb, JAARK_PCB_MOTOR.kicad_sch]
2026-02-07 PCB Motor V1 finished.
    [JAARK_PCB_MOTOR.kicad_pcb, JAARK_PCB_MOTOR.kicad_sch]
2026-02-07 Added mounting holes to Motor PCB, fixed up trace errors
    [JAARK_PCB_MOTOR.kicad_pcb]
2026-02-07 forgot one thing
    [JAARK_PCB_MOTOR.kicad_pcb]
2026-02-08 "Added heat sink"
    [JAARK_PCB_MOTOR.kicad_sch]
2026-02-08 Added heat sink to PCB file and adjusted footprint
    [JAARK_PCB_MOTOR.kicad_pcb, JAARK_PCB_MOTOR.kicad_sch]
2026-02-08 More work on PCB, removed heatsink and then added mounting holes again
    [JAARK_PCB_MOTOR.csv, JAARK_PCB_MOTOR.kicad_pcb, JAARK_PCB_MOTOR.kicad_sch, JAARK_PCB_MOTOR.xlsx, JAARK_PCB_MOTOR_BOM.xlsx]
2026-02-09 Fixed motor positioning.
    [JAARK_PCB_MOTOR.kicad_pcb]
2026-02-09 Bluetooth module
    [JAARK_PCB_MOTOR.kicad_pcb]
2026-02-10 Motor PCB finished?
    [JAARK_PCB_MOTOR.kicad_pcb, JAARK_PCB_MOTOR.kicad_sch]
2026-02-10 added test points
    [JAARK_PCB_MOTOR.kicad_pcb, JAARK_PCB_MOTOR.kicad_sch]
2026-02-10 JLCPCB compatibility
    [JAARK_PCB_MOTOR.csv, JAARK_PCB_MOTOR.kicad_pcb, JAARK_PCB_MOTOR.kicad_sch, JAARK_PCB_MOTOR.xlsx, bom.csv, designators.csv, positions.csv]
2026-02-12 Final prototype of PCB
    [JAARK_PCB_MOTOR.kicad_pcb, JAARK_PCB_MOTOR.kicad_sch, bom.csv, designators.csv, positions.csv]
2026-03-01 Ultrasonic sensor code working on the STM32 with custom LCD driver
    [JAARK_PCB_MOTOR-B_Cu.gbl, JAARK_PCB_MOTOR-B_Mask.gbs, JAARK_PCB_MOTOR-B_Paste.gbp, JAARK_PCB_MOTOR-B_Silkscreen.gbo, JAARK_PCB_MOTOR-Edge_Cuts.gm1, JAARK_PCB_MOTOR-F_Cu.gtl, JAARK_PCB_MOTOR-F_Mask.gts, JAARK_PCB_MOTOR-F_Paste.gtp]
2026-03-04 Working code for ultrasonic
2026-03-16 Bluetooth connectivity and DMA added, as well as controller stm folder
2026-03-16 Bluetooth working with joystick, DMA implementation
2026-03-23 Motor-side BT watchdog and distance sensor sending implemented, not tested
2026-03-28 Made 2way work with bluetooth, also metal detector algorithm works with the sensor code and watchdog.
2026-04-10 Working final product, going to try and change buzzer pin
